mat3ck/eirbot1a_2018/README.md

# eirbot1a_2018

Eirbot first year team project for 2018 France Championship of Robotics 
___
Projet de l'equipe 1A d'Eirbot pour la coupe de France de robotique 2018
