mat3ck/eirbot1a_2018/software/README.md

# Dependencies

## With make
You can use makefile in `eirbot1a_2018/software`, it needs :  
make  
arm-none-eabi-gcc  
arm-nonce-eabi-newlib  
arm-none-eabi-binutils  

## With PlatformIO
You can also use `eirbot1a_2018/platformio.ini` if you use PlatformIO
