mat3ck/eirbot1a_2018/(list of files, cad)

Other CAD files:
3d/cannon/asm_ax12_gear/Design Accelerator/asm_cyclindric_gear.iam
3d/cannon/asm_ax12_gear/Design Accelerator/cylindric_gear.ipt
3d/cannon/asm_cannon.iam
3d/cannon/asm_cannon/Design Accelerator/asm_cyclindric_gear.iam
3d/cannon/asm_cannon/Design Accelerator/cylindric_gear.ipt
3d/cannon/asm_return_wheel.iam
3d/cannon/ax12.ipt
3d/cannon/ax12_beam.ipt
3d/cannon/ax12_gear.iam
3d/cannon/ax12_support.ipt
3d/cannon/axis.ipt
3d/cannon/axis_support.ipt
3d/cannon/bottom.ipt
3d/cannon/bottom_2.ipt
3d/cannon/cannon.ipt
3d/cannon/cannon_gear.ipt
3d/cannon/return_wheel.ipt
3d/clamp/29mm_support_bottom.ipt
3d/clamp/29mm_support_top.ipt
3d/clamp/asm_ax12_clamp_support.iam
3d/clamp/ax12_support.ipt
3d/clamp/clamp_left.ipt
3d/clamp/clamp_right.ipt
3d/clamp/pulley_support_bottom.ipt
3d/clamp/stepper_motor.ipt
3d/clamp/stepper_pulley.ipt
3d/mir_base/mir_base.ipt
3d/sir_base/sir_base.ipt
