mat3ck/eirbot1a_2018/pcb/buck_converter/buck_converter.asc

C1: cap; 10µ; V=16 Irms=7.16 Rser=0.00732742 Lser=0 mfg="KEMET" pn="C1206C106K4PAC" type="X5R"
D1: schottky; 1N5819
L1: ind; 27µ; Ipk=1 Rser=0.061 Rpar=0 Cpar=0
M1: nmos; IRFH5300
V1: voltage; 18
V2: voltage; PULSE(0 18 0 0 0 2u 28u)
Named nets: 0
.tran 0 10m 0
