mat3ck/eirbot1a_2018/(list of files, drawings)

Other design files:
pcb/buck_converter/buck_converter.pdsprj
