mat3ck/eirbot1a_2018/pcb/buck_converter/buck_converter.kicad_pcb

## KiCad design pcb/buck_converter/buck_converter.kicad_pcb (2018-02-25)

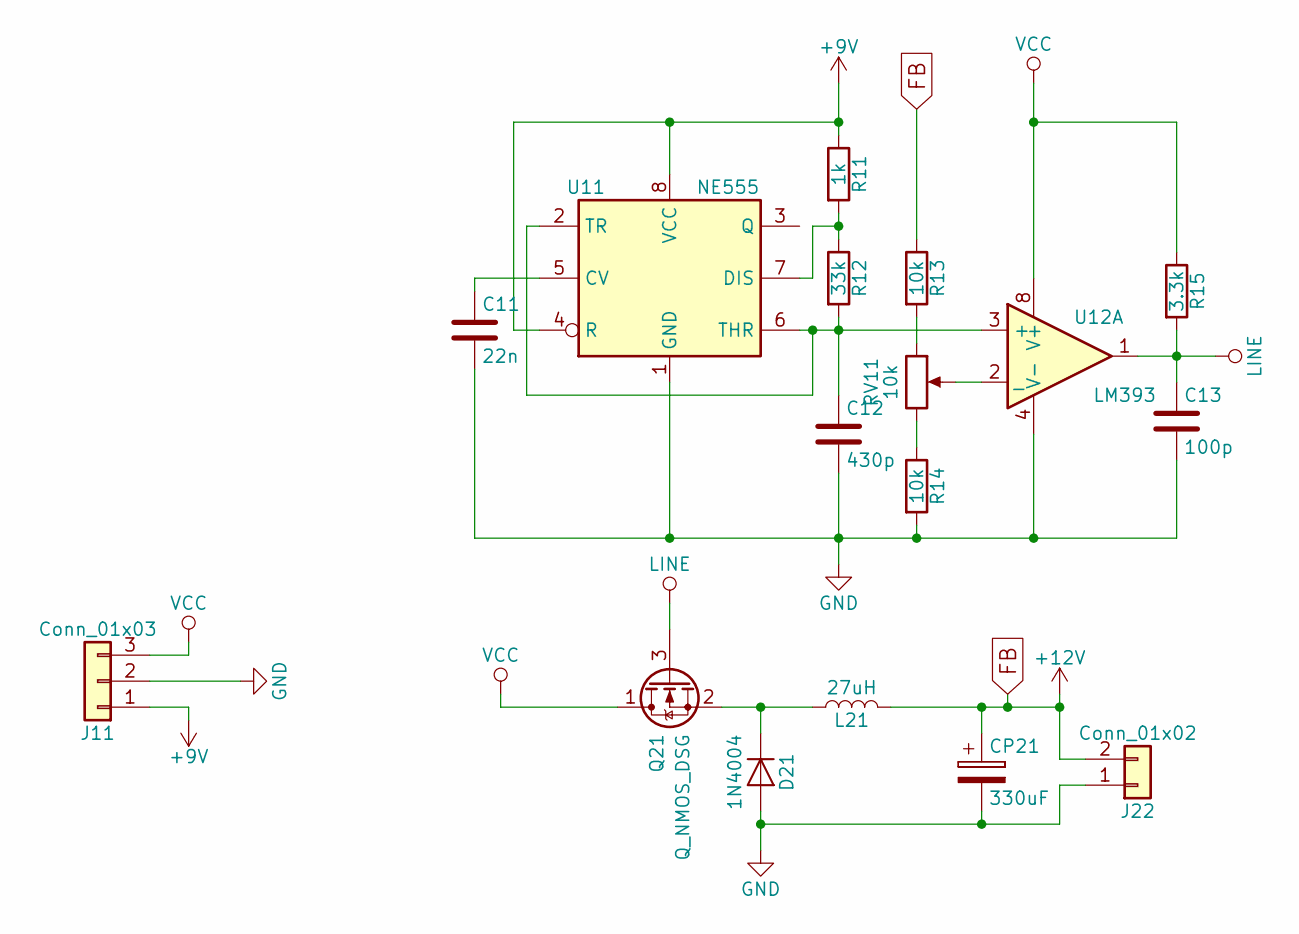
[picture p1: schematic buck_converter.sch]

Parts:
C11: 22n; C_0805_HandSoldering
C12: 430p; C_Disc_D4.7mm_W2.5mm_P5.00mm
C13: 100p; C_0805_HandSoldering
CP21: 330uF; CP_Radial_D10.0mm_P5.00mm
D21: 1N4004; D_A-405_P10.16mm_Horizontal
J11: Conn_01x03; PhoenixContact_MC-G_03x3.81mm_Angled
J22: Conn_01x02; PhoenixContact_MC-G_02x3.81mm_Angled
L21: 27uH; L_Radial_D8.7mm_P5.00mm_Fastron_07HCP
Q21: Q_NMOS_DSG; TO-220-3_Vertical
R11: 1k; R_0805_HandSoldering
R12: 33k; R_0805_HandSoldering
R13, R14: 10k; R_0805_HandSoldering
R15: 3.3k; R_0805_HandSoldering
RV11: 10k; Potentiometer_Trimmer_Bourns_3296Y
U11: NE555; DIP-8_W7.62mm_LongPads
U12: LM393; DIP-8_W7.62mm_LongPads

Connections:
+9V: J11.1, R11.1, U11.4 (R), U11.8 (VCC)
FB: CP21.1, J22.2, L21.2, R13.1
GND: C11.2, C12.2, C13.2, CP21.2, D21.2 (A), J11.2, J22.1, R14.2, U11.1 (GND), U12.4 (V-)
LINE: C13.1, Q21.3 (G), R15.2, U12.1
unnamed: C11.1, U11.5 (CV)
unnamed: C12.1, R12.2, U11.2 (TR), U11.6 (THR), U12.3 (+)
unnamed: D21.1 (K), L21.1, Q21.2 (S)
unnamed: R11.2, R12.1, U11.7 (DIS)
unnamed: R13.2, RV11.1
unnamed: R14.1, RV11.3
unnamed: RV11.2, U12.2 (_)
VCC: J11.3, Q21.1 (D), R15.1, U12.8 (V+)

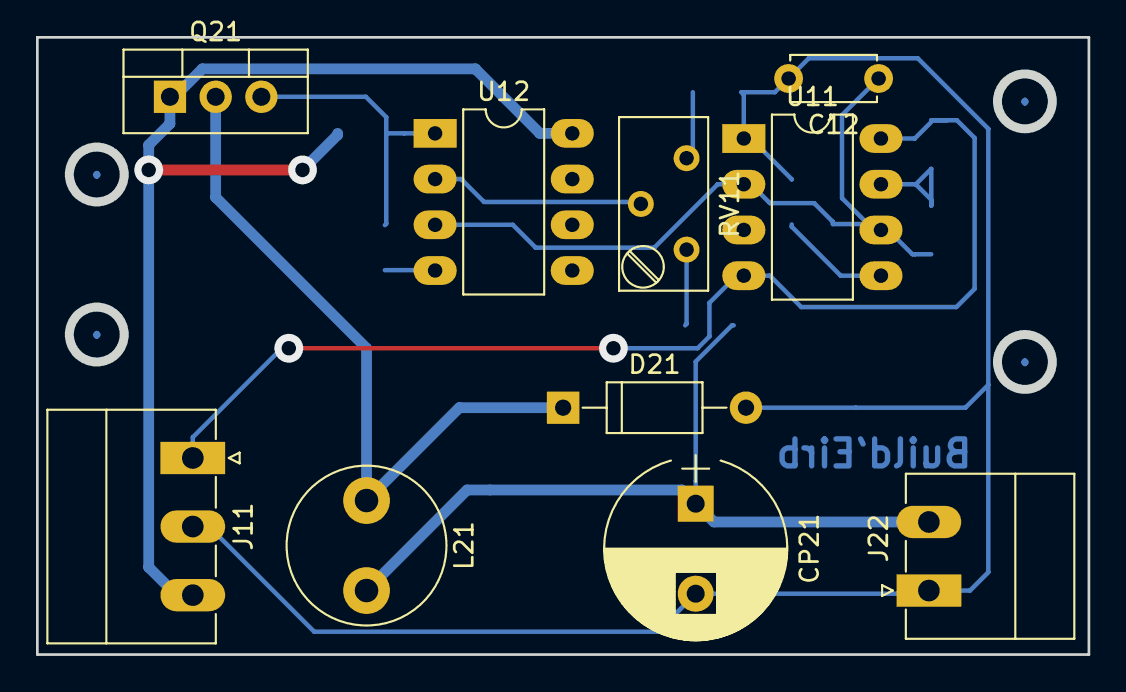
[picture p2: board buck_converter.kicad_pcb from above]

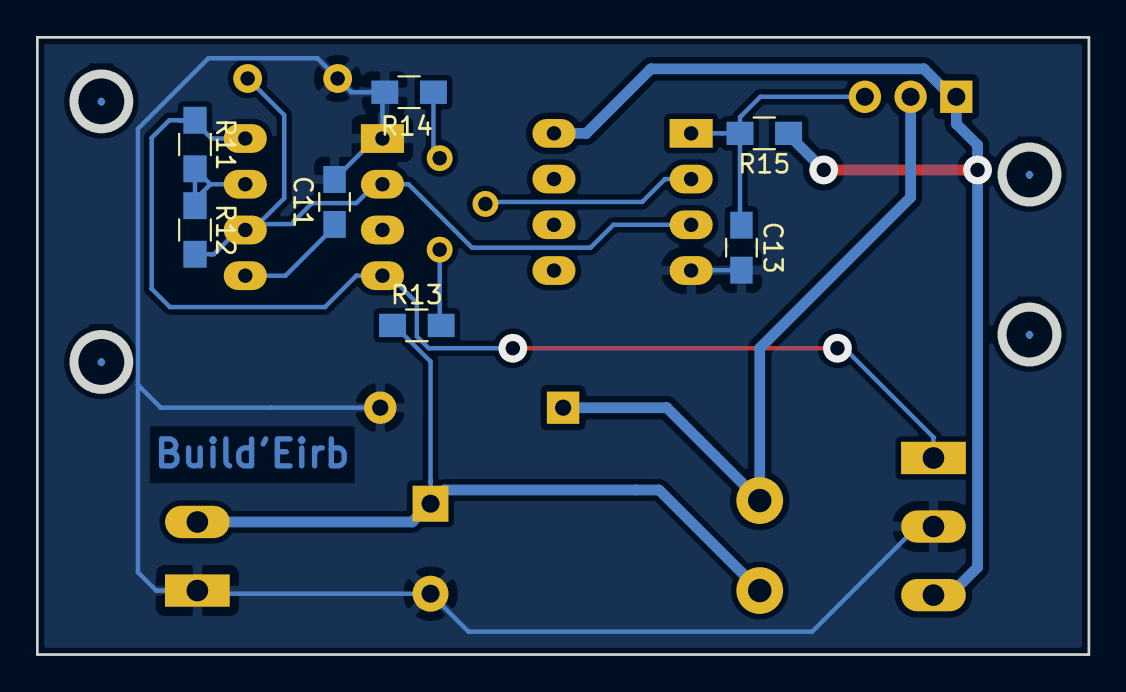
[picture p3: board buck_converter.kicad_pcb from below]

Board: 2 copper layers, 58.4 x 34.3 mm, 17 parts (7 on the bottom side), 12 nets.
