mat3ck/eirbot1a_2018/pcb/power_board/power_board.kicad_pcb

## KiCad design pcb/power_board/power_board.kicad_pcb (2018-02-25)

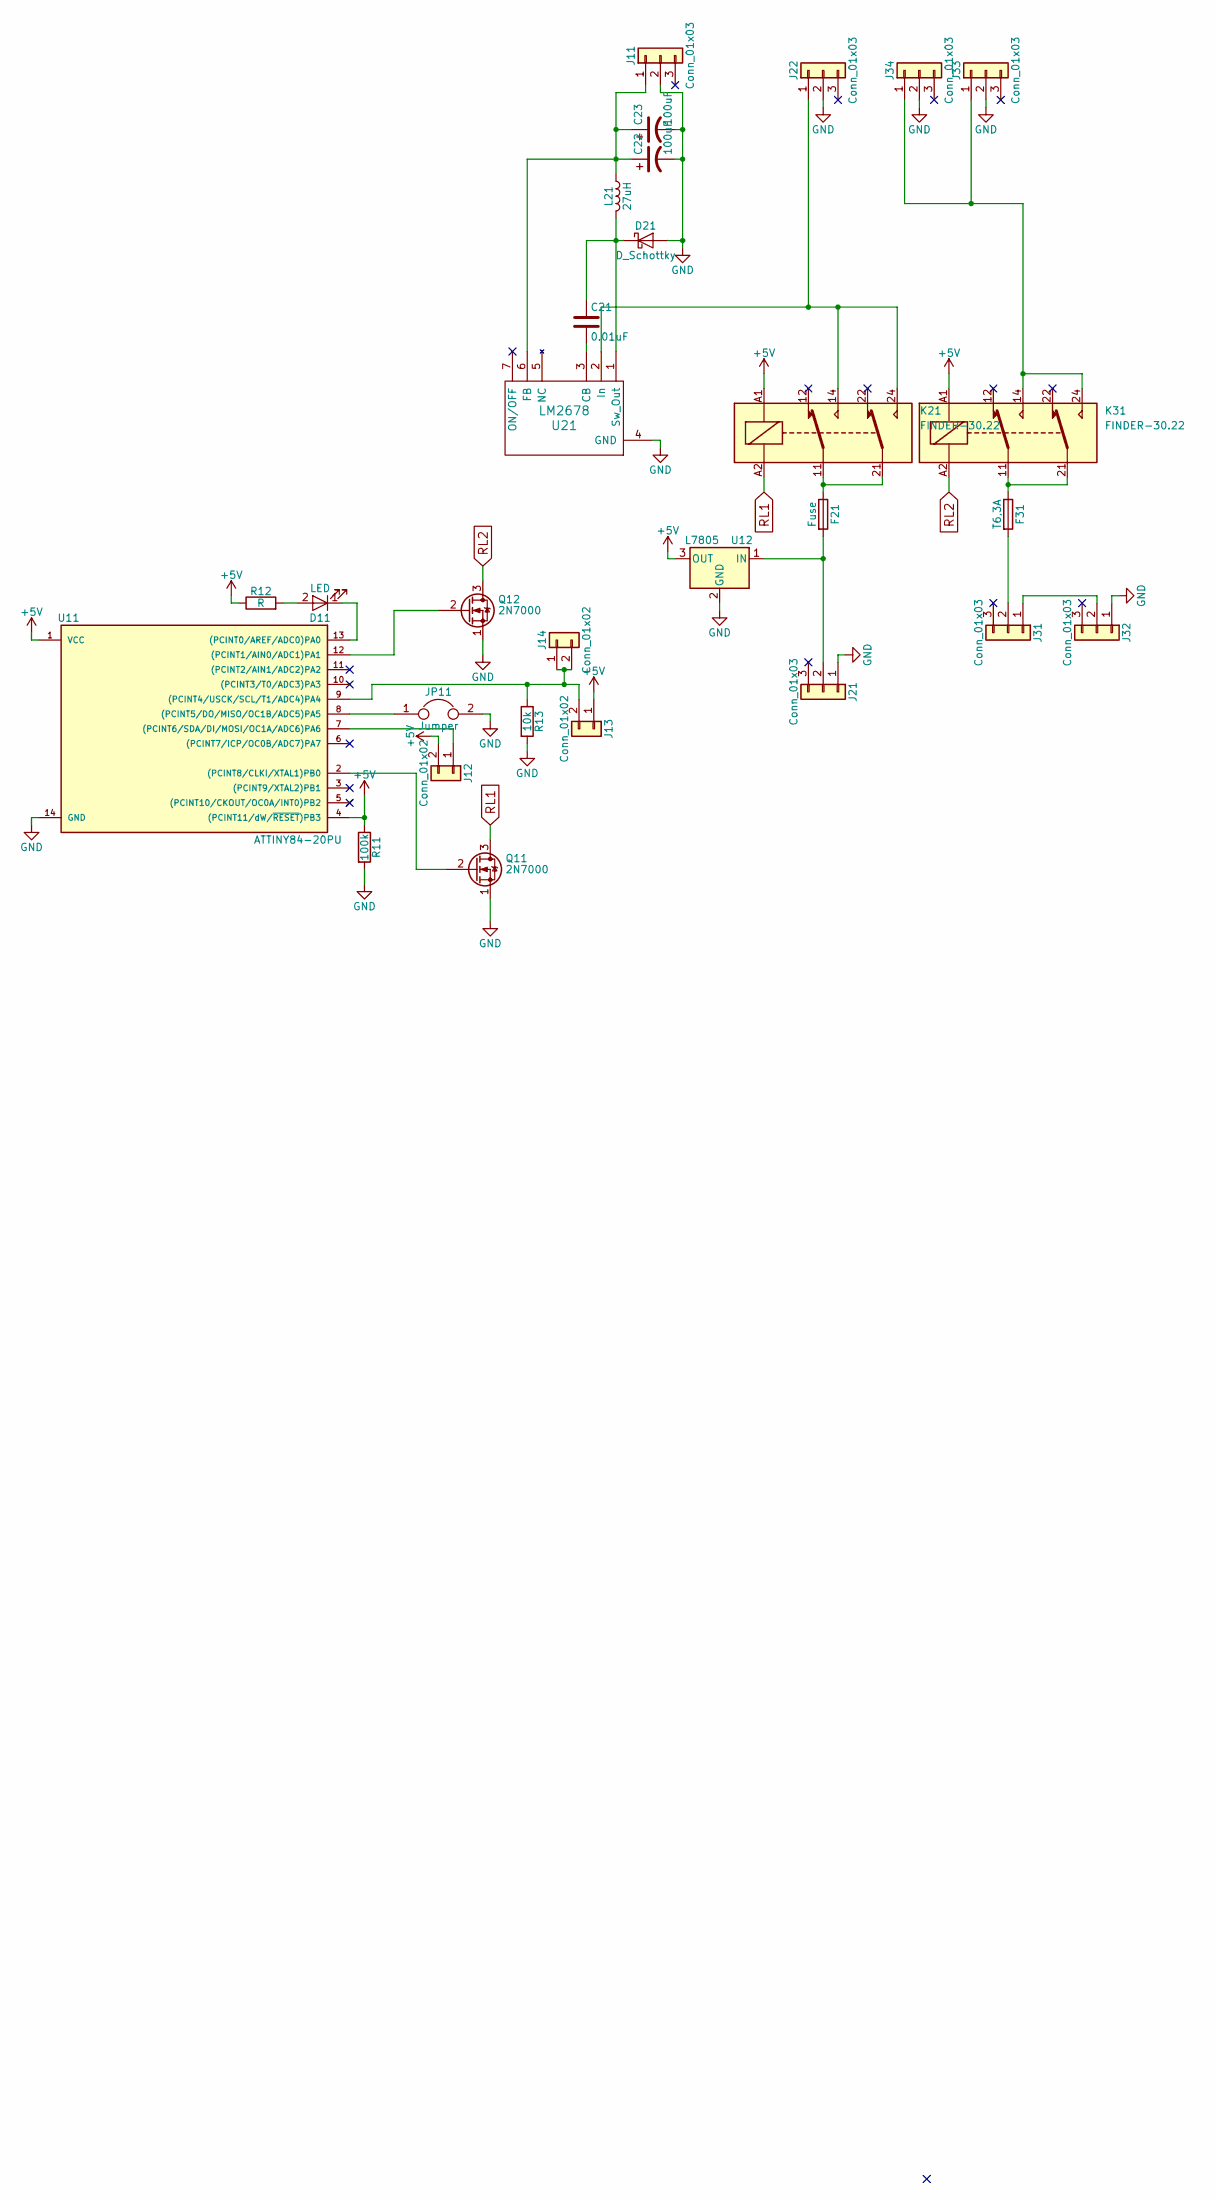
[picture p4: schematic power_board.sch]

Parts:
C21: 0.01uF; C_Disc_D4.3mm_W1.9mm_P5.00mm
C22, C23: 100uF; CP_Radial_D6.3mm_P2.50mm
D11: LED; LED_1206_HandSoldering
D21: D_Schottky; D_DO-41_SOD81_P7.62mm_Horizontal
F21: Fuse; Fuseholder5x20_horiz_open_inline_Type-I
F31: T6,3A; Fuseholder5x20_horiz_open_inline_Type-I
J11, J21, J22, J31, J32, J33, J34: Conn_01x03; PhoenixContact_MC-G_03x3.81mm_Angled
J12, J13: Conn_01x02; PhoenixContact_MC-G_02x3.81mm_Angled
J14: Conn_01x02; Pin_Header_Straight_1x02_Pitch2.54mm
JP11: Jumper; Test_Point_2Pads
K21, K31: FINDER-30.22; Relay_DPDT_Finder_40.52
L21: 27uH; L_Radial_D7.8mm_P5.00mm_Fastron_07HCP
Q11, Q12: 2N7000; TO-92_Molded_Narrow
R11: 100k; R_0805_HandSoldering
R12: R; R_0805_HandSoldering
R13: 10k; R_0805_HandSoldering
U11: ATTINY84-20PU; DIP-14_W7.62mm
U12: L7805; TO-220-3_Vertical
U21: LM2678; TO-220-7_Vertical_StaggeredType1

Connections:
+5V: J12.2, J13.1, K21.A1, K31.A1, R11.1, R12.1, U11.1 (VCC), U11.4 ((PCINT11/dW/~RESET~)PB3), U12.3 (OUT)
GND: C22.2, C23.2, D21.2 (A), J11.2, J21.1, J22.2, J32.1, J33.2, J34.2, JP11.2, Q11.1 (S), Q12.1 (S), R11.2, R13.2, U11.14 (GND), U12.2 (GND), U21.4 (GND)
unnamed: C21.1, D21.1 (K), L21.2, U21.1 (Sw_Out)
unnamed: C21.2, U21.3 (CB)
unnamed: C22.1, C23.1, J11.1, L21.1, U21.6 (FB)
unnamed: D11.1 (K), U11.13 ((PCINT0/AREF/ADC0)PA0)
unnamed: D11.2 (A), R12.2
unnamed: F21.1, K21.11, K21.21
unnamed: F21.2, J21.2, U12.1 (IN)
unnamed: F31.1, K31.11, K31.21
unnamed: F31.2, J31.2
unnamed: J12.1, U11.7 ((PCINT6/SDA/DI/MOSI/OC1A/ADC6)PA6)
unnamed: J13.2, J14.1, J14.2, R13.1, U11.9 ((PCINT4/USCK/SCL/T1/ADC4)PA4)
unnamed: J22.1, K21.14, K21.24, U21.2 (In)
unnamed: J31.1, J32.2
unnamed: J33.1, J34.1, K31.14, K31.24
unnamed: JP11.1, U11.8 ((PCINT5/DO/MISO/OC1B/ADC5)PA5)
unnamed: Q11.2 (G), U11.2 ((PCINT8/CLKI/XTAL1)PB0)
unnamed: Q12.2 (G), U11.12 ((PCINT1/AIN0/ADC1)PA1)
RL1: K21.A2, Q11.3 (D)
RL2: K31.A2, Q12.3 (D)

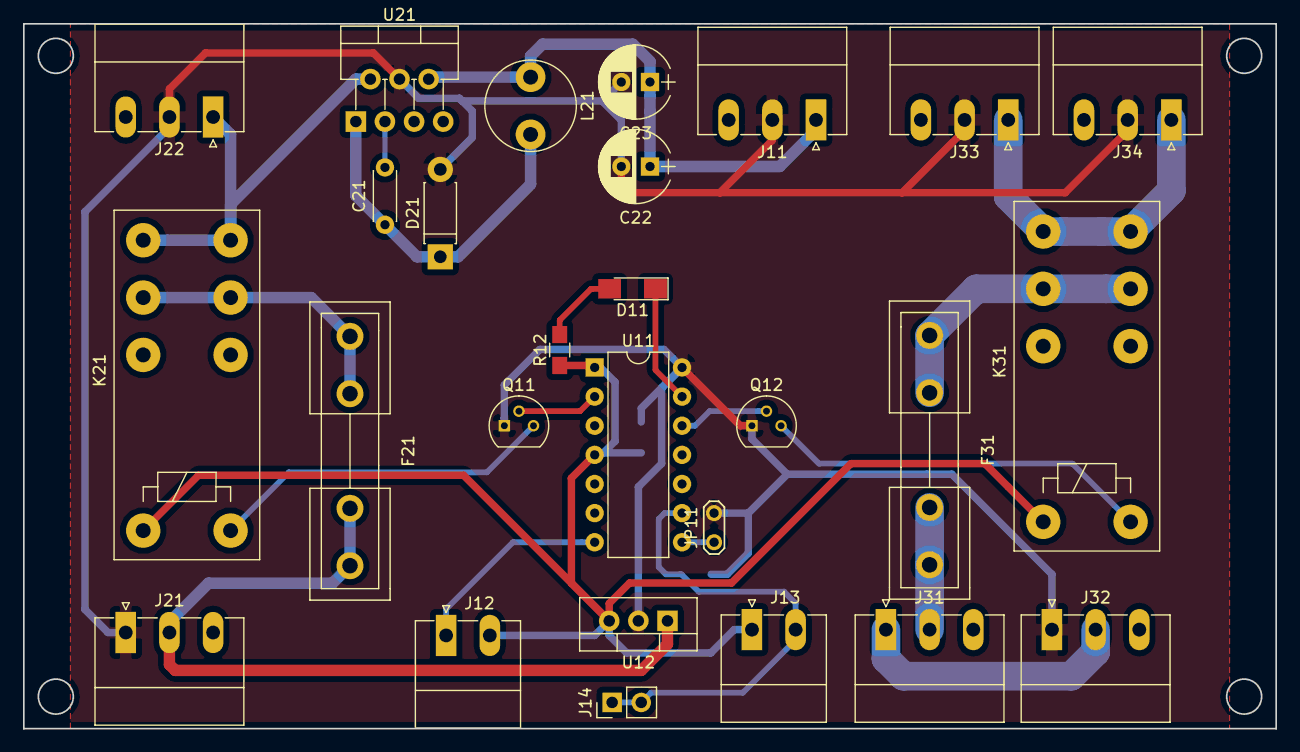
[picture p5: board power_board.kicad_pcb from above]

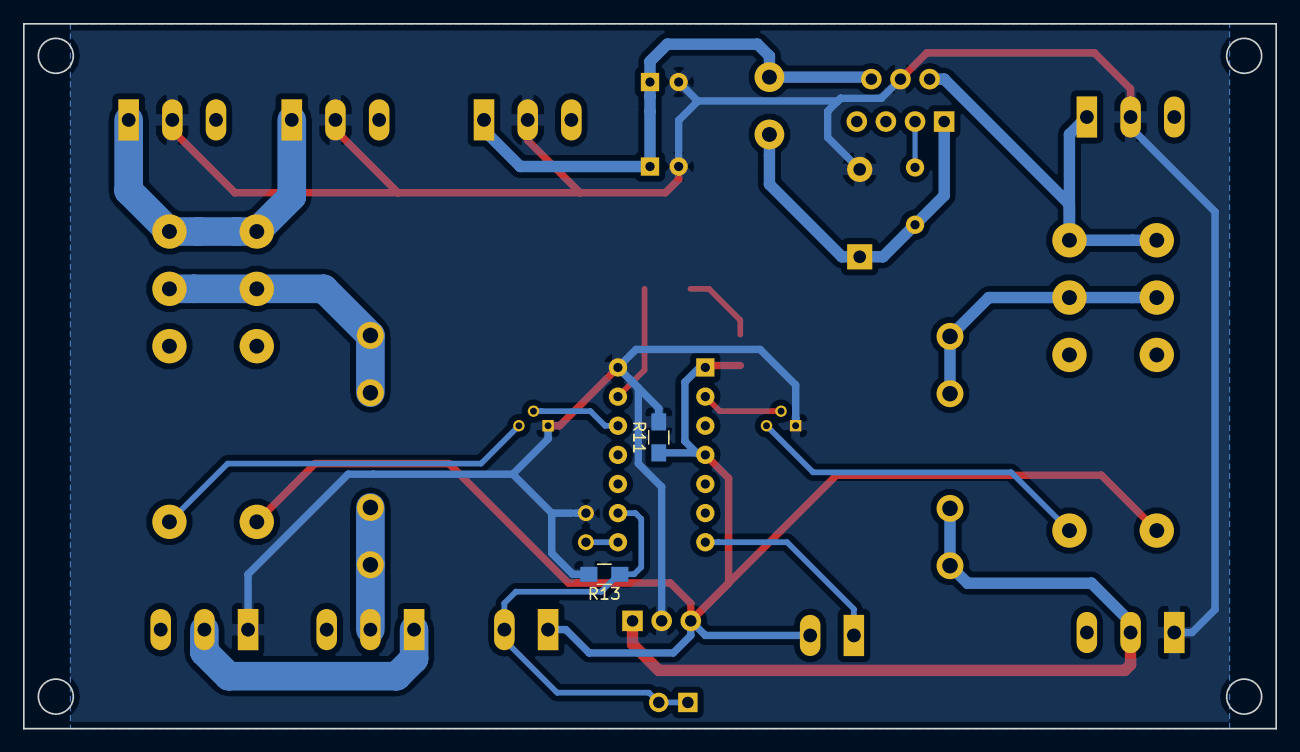
[picture p6: board power_board.kicad_pcb from below]

Board: 2 copper layers, 109.2 x 61.5 mm, 29 parts (2 on the bottom side), 21 nets.
