mat3ck/eirbot1a_2018/pcb/7seg/7seg_encoder/7seg_encoder.kicad_pcb

## KiCad design pcb/7seg/7seg_encoder/7seg_encoder.kicad_pcb (2018-02-25)

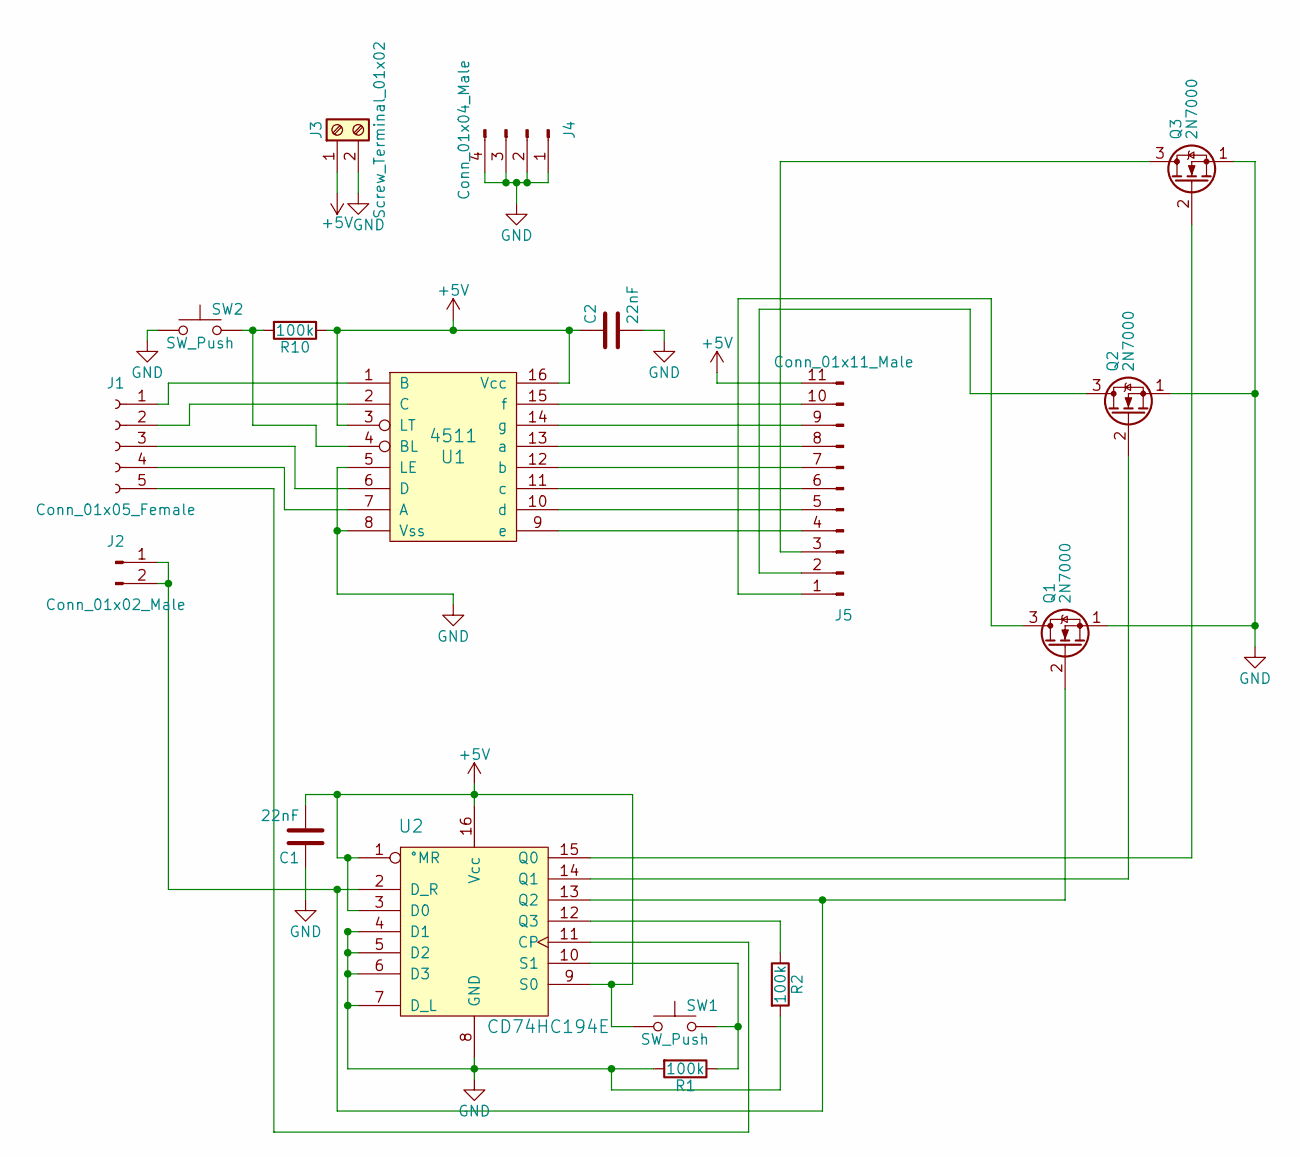
[picture p7: schematic 7seg_encoder.sch, Decodeur 3 digit 7 segments]

Parts:
C1, C2: 22nF; C_Disc_D4.3mm_W1.9mm_P5.00mm
J1: Conn_01x05_Female; Socket_Strip_Angled_1x05_Pitch2.54mm
J2: Conn_01x02_Male; Pin_Header_Angled_1x02_Pitch2.54mm
J3: Screw_Terminal_01x02; TerminalBlock_Phoenix_MPT-2.54mm_2pol
J4: Conn_01x04_Male; Pin_Header_Straight_1x04_Pitch2.54mm
J5: Conn_01x11_Male; Pin_Header_Straight_1x11_Pitch2.54mm
Q1, Q2, Q3: 2N7000; TO-92_Molded_Wide
R1, R2, R10: 100k; R_Axial_DIN0204_L3.6mm_D1.6mm_P7.62mm_Horizontal
SW1, SW2: SW_Push; SW_PUSH_6mm
U1: 4511; DIP-16_W7.62mm_Socket
U2: CD74HC194E; SOIC-16_3.9x9.9mm_Pitch1.27mm

Connections:
+5V: C1.2, C2.1, J3.1, J5.11, R10.1, SW1.1, U1.3 (LT), U1.16 (Vcc), U2.1 (°MR), U2.3 (D0), U2.9 (S0), U2.16 (Vcc)
GND: C1.1, C2.2, J3.2, J4.1, J4.2, J4.3, J4.4, Q1.1 (S), Q2.1 (S), Q3.1 (S), R1.2, R2.2, SW2.1, U1.5 (LE), U1.8 (Vss), U2.4 (D1), U2.5 (D2), U2.6 (D3), U2.7 (D_L), U2.8 (GND)
unnamed: J1.1, U1.1 (B)
unnamed: J1.2, U1.2 (C)
unnamed: J1.3, U1.6 (D)
unnamed: J1.4, U1.7 (A)
unnamed: J1.5, U2.11 (CP)
unnamed: J2.1, J2.2, Q1.2 (G), U2.2 (D_R), U2.13 (Q2)
unnamed: J5.1, Q1.3 (D)
unnamed: J5.2, Q2.3 (D)
unnamed: J5.3, Q3.3 (D)
unnamed: J5.4, U1.9 (e)
unnamed: J5.5, U1.10 (d)
unnamed: J5.6, U1.11 (c)
unnamed: J5.7, U1.12 (b)
unnamed: J5.8, U1.13 (a)
unnamed: J5.9, U1.14 (g)
unnamed: J5.10, U1.15 (f)
unnamed: Q2.2 (G), U2.14 (Q1)
unnamed: Q3.2 (G), U2.15 (Q0)
unnamed: R1.1, SW1.2, U2.10 (S1)
unnamed: R2.1, U2.12 (Q3)
unnamed: R10.2, SW2.2, U1.4 (BL)

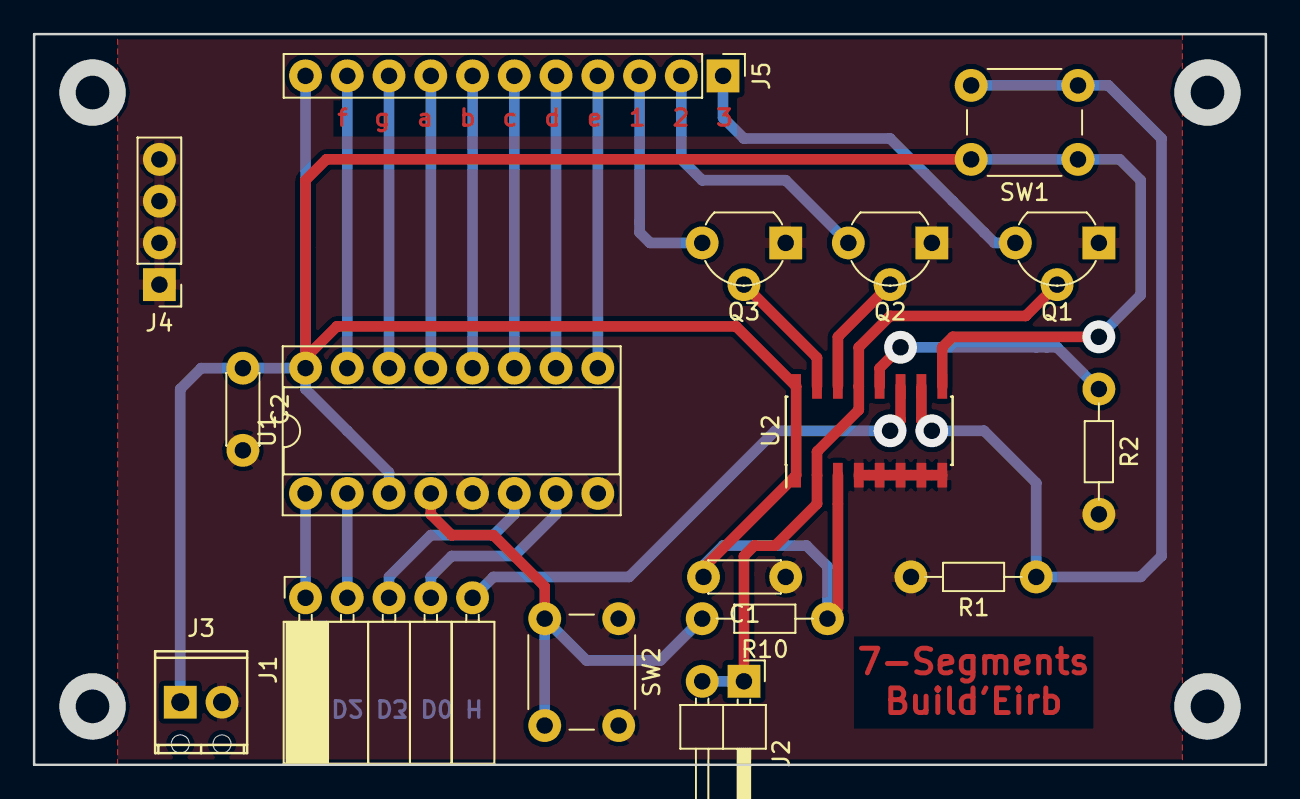
[picture p8: board 7seg_encoder.kicad_pcb from above]

Board: 2 copper layers, 74.9 x 44.5 mm, 17 parts (0 on the bottom side), 23 nets.
