mat3ck/eirbot1a_2018/pcb/7seg/7seg_display/7seg_display.kicad_pcb

## KiCad design pcb/7seg/7seg_display/7seg_display.kicad_pcb (2018-02-25)

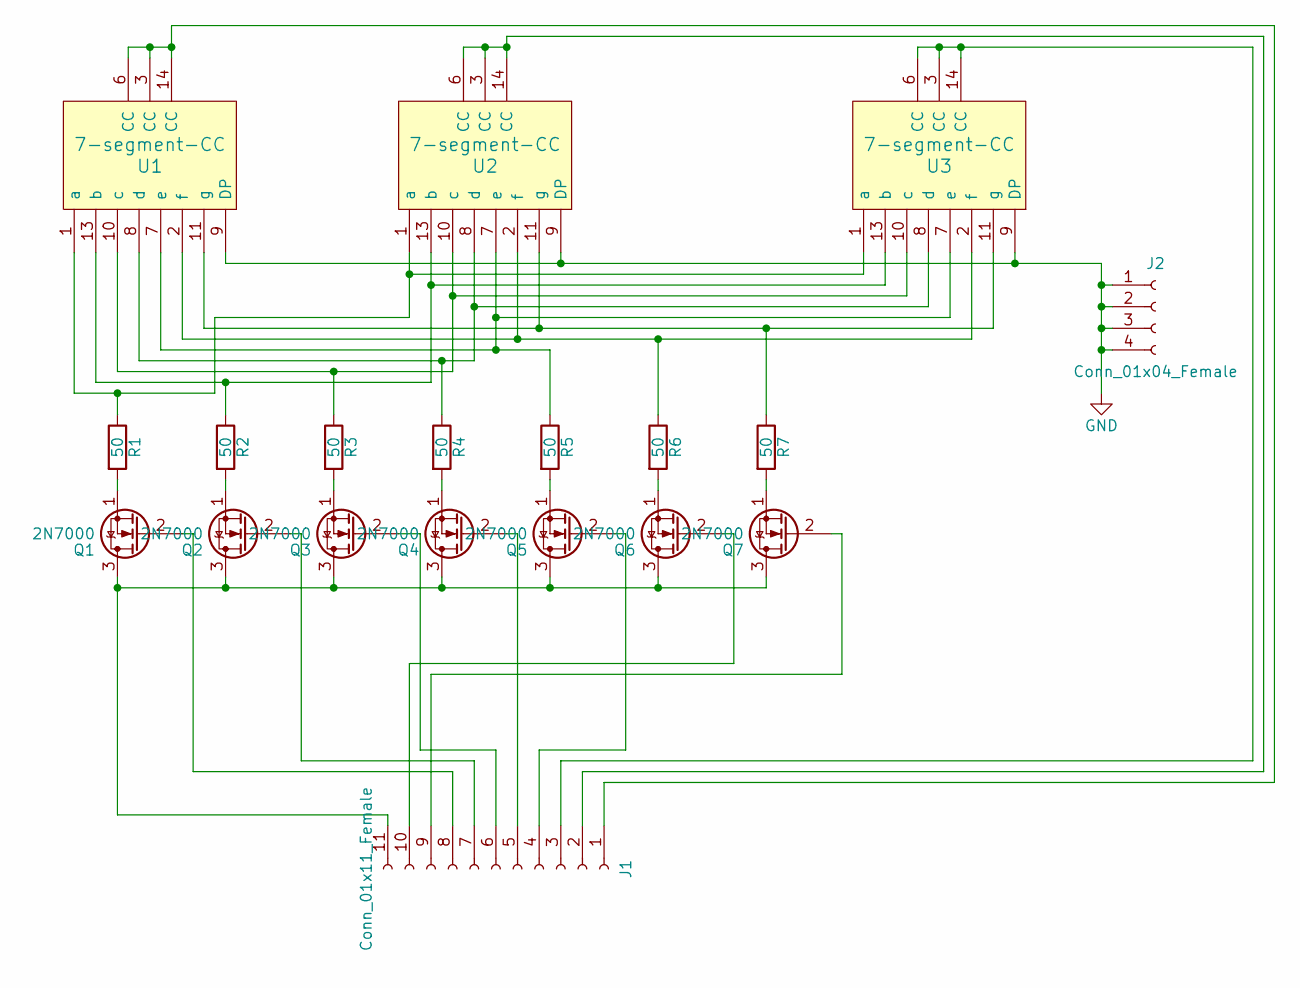
[picture p9: schematic 7seg_display.sch]

Parts:
J1: Conn_01x11_Female; Socket_Strip_Straight_1x11_Pitch2.54mm
J2: Conn_01x04_Female; Socket_Strip_Straight_1x04_Pitch2.54mm
Q1, Q2, Q3, Q4, Q5, Q6, Q7: 2N7000; TO-92_Molded_Wide
R1, R2, R3, R4, R5, R6, R7: 50; R_0805_HandSoldering
U1, U2, U3: 7-segment-CC; 7-segment_CC

Connections:
GND: J2.1, J2.2, J2.3, J2.4, U1.9 (DP), U2.9 (DP), U3.9 (DP)
unnamed: J1.1, U1.3 (CC), U1.6 (CC), U1.14 (CC)
unnamed: J1.2, U2.3 (CC), U2.6 (CC), U2.14 (CC)
unnamed: J1.3, U3.3 (CC), U3.6 (CC), U3.14 (CC)
unnamed: J1.4, Q5.2 (G)
unnamed: J1.5, Q4.2 (G)
unnamed: J1.6, Q3.2 (G)
unnamed: J1.7, Q2.2 (G)
unnamed: J1.8, Q1.2 (G)
unnamed: J1.9, Q7.2 (G)
unnamed: J1.10, Q6.2 (G)
unnamed: J1.11, Q1.3 (D), Q2.3 (D), Q3.3 (D), Q4.3 (D), Q5.3 (D), Q6.3 (D), Q7.3 (D)
unnamed: Q1.1 (S), R1.2
unnamed: Q2.1 (S), R2.2
unnamed: Q3.1 (S), R3.2
unnamed: Q4.1 (S), R4.2
unnamed: Q5.1 (S), R5.2
unnamed: Q6.1 (S), R6.2
unnamed: Q7.1 (S), R7.2
unnamed: R1.1, U1.1 (a), U2.1 (a), U3.1 (a)
unnamed: R2.1, U1.13 (b), U2.13 (b), U3.13 (b)
unnamed: R3.1, U1.10 (c), U2.10 (c), U3.10 (c)
unnamed: R4.1, U1.8 (d), U2.8 (d), U3.8 (d)
unnamed: R5.1, U1.7 (e), U2.7 (e), U3.7 (e)
unnamed: R6.1, U1.2 (f), U2.2 (f), U3.2 (f)
unnamed: R7.1, U1.11 (g), U2.11 (g), U3.11 (g)

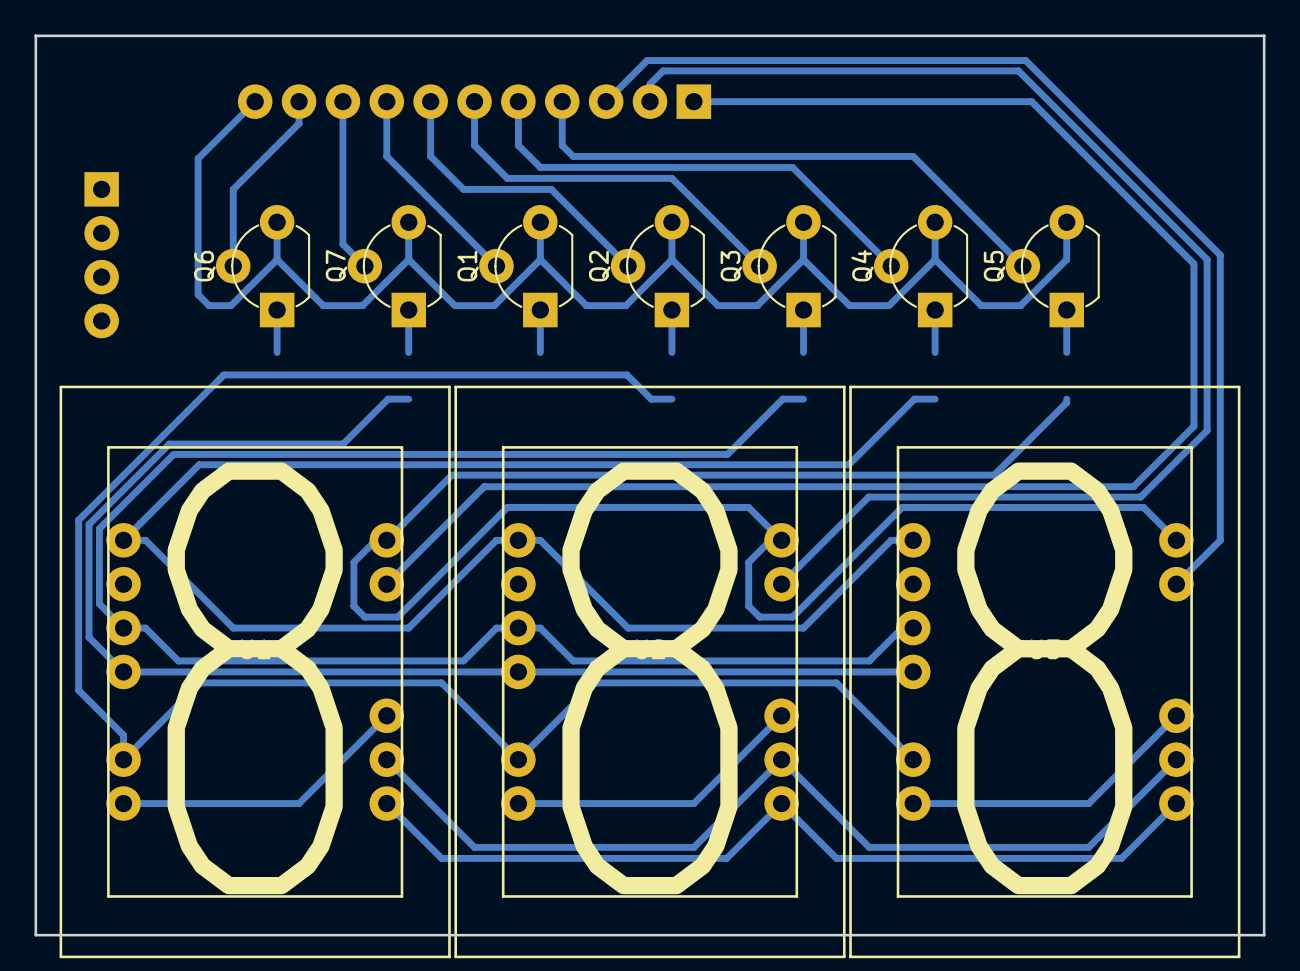
[picture p10: board 7seg_display.kicad_pcb from above]

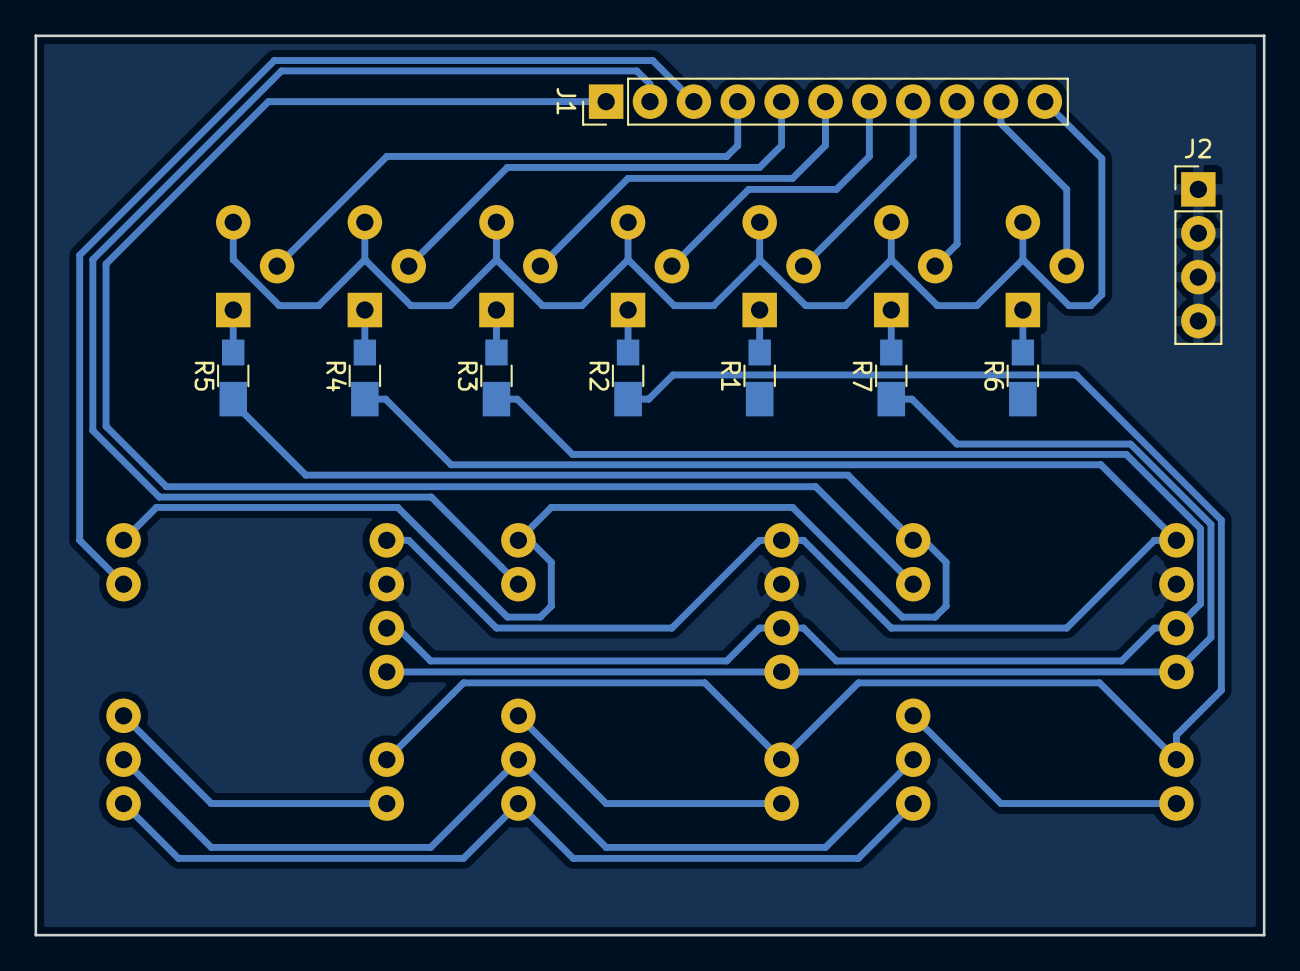
[picture p11: board 7seg_display.kicad_pcb from below]

Board: 2 copper layers, 71.1 x 52.1 mm, 19 parts (9 on the bottom side), 26 nets.
