mat3ck/eirbot1a_2018/software/nucleo_sir/main.cpp

/*
 * TODO
 *
 */

#include "mbed.h"
#include "config.hpp"
#include "error.hpp"
#include "qei.hpp"
#include "motor.hpp"
#include "pid.hpp"
#include "block.hpp"
#include "navigator.hpp"
#include "gp2.hpp"


int err = 0;

float coef_err_l[] = {K1_ERR_L, K2_ERR_L, K3_ERR_L, K4_ERR_L};
float coef_sp_l[] = {K1_SP_L, K2_SP_L, K3_SP_L};
float coef_err_r[] = {K1_ERR_R, K2_ERR_R, K3_ERR_R, K4_ERR_R};
float coef_sp_r[] = {K1_SP_R, K2_SP_R, K3_SP_R};

// Led
DigitalOut led(LED3);
//PwmOut test(PA_10);
// Serial PC
Serial pc(USBTX, USBRX, 115200);
Serial rasp(RASP_TX, RASP_RX, 115200);
// Qeis
Qei qei_l(ENCODER_TIM_LEFT, err, SIR);
Qei qei_r(ENCODER_TIM_RIGHT, err, SIR);
// Speed PIDs
Pid pid_l(coef_err_l, NB_COEF_ERR, coef_sp_l, NB_COEF_SP);
Pid pid_r(coef_err_r, NB_COEF_ERR, coef_sp_r, NB_COEF_SP);
// Motors
Motor motor_l(PWM_L, DIR_L, BREAK_L, DIR_FWD_L, PERIOD_PWM);
//Motor motor_r(PWM_R, DIR_R, BREAK_R, DIR_FWD_R, PERIOD_PWM);
// Blocks
//Block block_l(qei_l, pid_l, motor_l, MAX_DUTY, PERIOD_PID);
//Block block_r(qei_r, pid_r, motor_r, MAX_DUTY, PERIOD_PID);
// Navigator
//Navigator navigator(block_l, block_r, PERIOD_PID, PERIOD_POS);

int main()
{
	wait(3);
	led = 0;
	pc.printf("\n\n\rStarting, error code : %d\n\r", err);
	motor_l.SetPwm(0.78f);
	float test_pwm=0.1f;
	while (1) {
		if(pc.readable()) {
			test_pwm=(float)pc.getc();
			test_pwm-=47.5f;
			test_pwm=test_pwm/10.0f;
			motor_l.SetPwm(test_pwm);
		}
//		if(rasp.readable()) {
//			pc.putc(rasp.getc());
//		}

		printf("lecture : %g\tpwm left : %g\n",test_pwm,motor_l.GetDuty());


	}
}
