mat3ck/eirbot1a_2018/software/nucleo_mir/mbed_config.h

/*
 * mbed SDK
 * Copyright (c) 2017 ARM Limited
 *
 * Licensed under the Apache License, Version 2.0 (the "License");
 * you may not use this file except in compliance with the License.
 * You may obtain a copy of the License at
 *
 * http://www.apache.org/licenses/LICENSE-2.0
 *
 * Unless required by applicable law or agreed to in writing, software
 * distributed under the License is distributed on an "AS IS" BASIS,
 * WITHOUT WARRANTIES OR CONDITIONS OF ANY KIND, either express or implied.
 * See the License for the specific language governing permissions and
 * limitations under the License.
 */

// Automatically generated configuration file.
// DO NOT EDIT, content will be overwritten.

#ifndef __MBED_CONFIG_DATA__
#define __MBED_CONFIG_DATA__

// Configuration parameters
#define STM32_D11_SPI_ETHERNET_PIN                  PA_7                         // set by target:NUCLEO_F429ZI
#define MBED_CONF_PLATFORM_STDIO_BAUD_RATE          9600                         // set by library:platform
#define CLOCK_SOURCE                                USE_PLL_HSE_EXTC|USE_PLL_HSI // set by target:NUCLEO_F429ZI
#define MBED_CONF_PLATFORM_DEFAULT_SERIAL_BAUD_RATE 9600                         // set by library:platform
#define CLOCK_SOURCE_USB                            1                            // set by target:NUCLEO_F429ZI
#define MBED_CONF_PLATFORM_STDIO_FLUSH_AT_EXIT      1                            // set by library:platform
#define MBED_CONF_PLATFORM_STDIO_CONVERT_NEWLINES   0                            // set by library:platform

#endif
