mat3ck/eirbot1a_2018/software/tests/qei.cpp

#include "mbed.h"
#include "errors.h"
#include "pins_robot1.h"
#include "motors.h"
#include "qei.h"
#include "pid_robot1.h"


int err = 0;

Serial pc(USBTX, USBRX);
// Left Motor
PwmOut* p_pwm_left = new PwmOut(PIN_PWM_LEFT);
DigitalOut* p_direction_0_left = new DigitalOut(PIN_DIR_LEFT1);
DigitalOut* p_direction_1_left = new DigitalOut(PIN_DIR_LEFT2);
Motor motor_left(p_pwm_left, p_direction_0_left, p_direction_1_left);
// Right Motor
PwmOut* p_pwm_right = new PwmOut(PIN_PWM_RIGHT);
DigitalOut* p_direction_0_right = new DigitalOut(PIN_DIR_RIGHT1);
DigitalOut* p_direction_1_right = new DigitalOut(PIN_DIR_RIGHT2);
Motor motor_right(p_pwm_right, p_direction_0_right, p_direction_1_right);
// Left Qei
TIM_Encoder_InitTypeDef* p_encoder_left = new TIM_Encoder_InitTypeDef;
TIM_HandleTypeDef* p_htim_left = new TIM_HandleTypeDef;
TIM_TypeDef* p_TIMx_left = ENCODER_TIM_LEFT;
Qei qei_left(p_encoder_left, p_htim_left, p_TIMx_left, &err);
//Right Qei
TIM_Encoder_InitTypeDef* p_encoder_right = new TIM_Encoder_InitTypeDef;
TIM_HandleTypeDef* p_htim_right = new TIM_HandleTypeDef;
TIM_TypeDef* p_TIMx_right = ENCODER_TIM_RIGHT;
Qei qei_right(p_encoder_right, p_htim_right, p_TIMx_right, &err);


int main()
{
	int qei_l = 0;
	int qei_r = 0;
	int vl = 0;
	int vr = 0;
	wait(1);
	pc.printf("\n\rErreur : %d\n\r", err);
	while (1) {
		vl = qei_left.GetQei();
		vr = qei_right.GetQei();
		if (vl != 0 || vr !=0) {
			qei_l += vl;
			qei_r += vr;
			pc.printf("Left : %d\tVar : %d\tRight : %d\tVar : %d\n\r", 
				qei_l, vl, qei_r, vr);
			wait(0.01);
		}
	}
}
