mat3ck/eirbot1a_2018/(commit log)

2018-01-26 Renames, adding the errors.h filew
    [robot1.cpp]
2018-01-26 Debugged motors.cpp, types changing
2018-01-26 Prototype changes in new_motor, creation of pins file for robot1
2018-01-27 Debbuged compilation chain
2018-01-27 changed struct into class for motors
2018-01-28 Made Motor::SetPwm() public
2018-01-28 Indent in motors.h
2018-01-29 Style adjustments in motors.*
2018-01-29 Created a PID class
2018-01-30 Changed Pid and Motor classes to make a speed PID, still need work
2018-01-31 Changed types in motor class
2018-01-31 Changed motor class to work with tickers instead of timers
2018-01-31 Clean main with tickers for motors
2018-02-01 Made SetPid protected in class Pid
2018-02-01 Minor changes in Pid and Motor classes
2018-02-01 DO NOT USE, test main to set PID parameters
2018-02-04 Renames and added a timer to motor
2018-02-04 Added timers to motors
2018-02-04 Lightened motor class
2018-02-05 Added security to motors
2018-02-05 New block class to command motors at a higher level
2018-02-08 Made motor class simpler, removed security
2018-02-08 New class block to control motors at a higher level
2018-02-08 Renamed motor pins
2018-02-10 Added PID coef
2018-02-10 Changed PID structure and added circular array class
2018-02-10 New clean main with PID coef arrays
2018-02-14 Added GetPwm method to Motor
2018-02-14 Removed timer and changed pid call
2018-02-15 Changed PID coefficients
2018-02-15 Put Pid coef in parenthesis
2018-02-15 Changed printf spacings
2018-02-16 Manage direction for mirror motors
2018-02-19 Changed pid period
2018-02-20 Clean main with debug led
2018-02-20 Renamed led
2018-02-22 Print var_max as a float
2018-02-22 Changed Pid constructor prototype
2018-02-23 Reworked workspace to add more content
    [mbed_config.h]
2018-02-25 Added main robot 3d base
    [mir_base.ipt]
2018-02-25 Added side robot 3d base
    [sir_base.ipt]
2018-02-25 Added clamp 3d design
    [29mm_support_bottom.ipt, 29mm_support_top.ipt, asm_ax12_clamp_support.iam, ax12_support.ipt, clamp_left.ipt, clamp_right.ipt, pulley_support_bottom.ipt, stepper_motor.ipt]
2018-02-25 Added cannon 3d design
    [asm_cannon.iam, asm_cyclindric_gear.iam, asm_return_wheel.iam, ax12.ipt, ax12_beam.ipt, ax12_gear.iam, ax12_support.ipt, axis.ipt]
2018-02-25 Added 7 segments pcb
    [7seg_card.sch, 7seg_display.kicad_pcb, 7seg_display.sch, 7seg_encoder.kicad_pcb, 7seg_encoder.sch]
2018-02-25 Added 7 segments arduino script
2018-02-25 Added power board pcb design
    [power_board.kicad_pcb, power_board.sch]
2018-02-25 Added buck converter pcb design
    [buck_converter.kicad_pcb, buck_converter.pdsprj, buck_converter.sch]
2018-02-25 Added Arduino power board program
2018-03-01 Reworked Motor() to call it with PinNames
2018-03-01 Changed main to follow block and motors rework
    [main.cpp]
2018-03-01 Added Motor::Reset()
2018-03-01 Added Pid::Reset() and CArray::Reset()
2018-03-01 Fixed Pid
2018-03-01 Added Block::Start() to attach timer on demand
2018-03-03 Added different length support to Pid class
2018-03-03 Reworked Block to get references as parameters
    [main.cpp]
2018-03-03 Reworked Motor to use constructor initializer list
2018-03-04 Rework using constructor initializer list
    [main.cpp]
2018-03-04 Put parameters name in header prototype
2018-03-09 New main to test pid
2018-03-13 Changed references into pointers in Pid()
2018-03-13 Added 1m pid test
2018-03-13 Regrouped left and right pid coef
2018-03-13 Main to get transfer functions of the motors
2018-03-13 Renamed Motor::GetPwm() into Motor::GetDuty()
2018-03-13 Added parameters names into methods prototypes
2018-03-13 Moved constants and allow choosing pwm period
2018-03-13 Added motors parameters
2018-03-14 Added pwm duty and voltage into files
2018-03-15 add support for Timer3
2018-03-17 Changed motor directions
2018-03-17 Allow different period for pos and pid, fixed signe problems
2018-05-02 Changed motor dir and pwm max duty
2018-05-05 Changed closedLoop prototype
2018-05-05 Improved time printing
2018-05-05 New PID parameters and motor direction
